StanislavJochman/ROBa-project/bumper.3mf

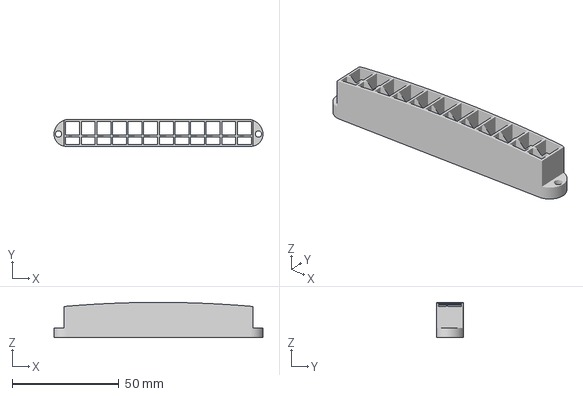
[picture p10: CAD file, 2023-11-16]
bumper.3mf
97.7 x 12.5 x 16.5 mm
