StanislavJochman/ROBa-project/LineFollower.brd

## EAGLE design LineFollower.brd (2023-11-15)

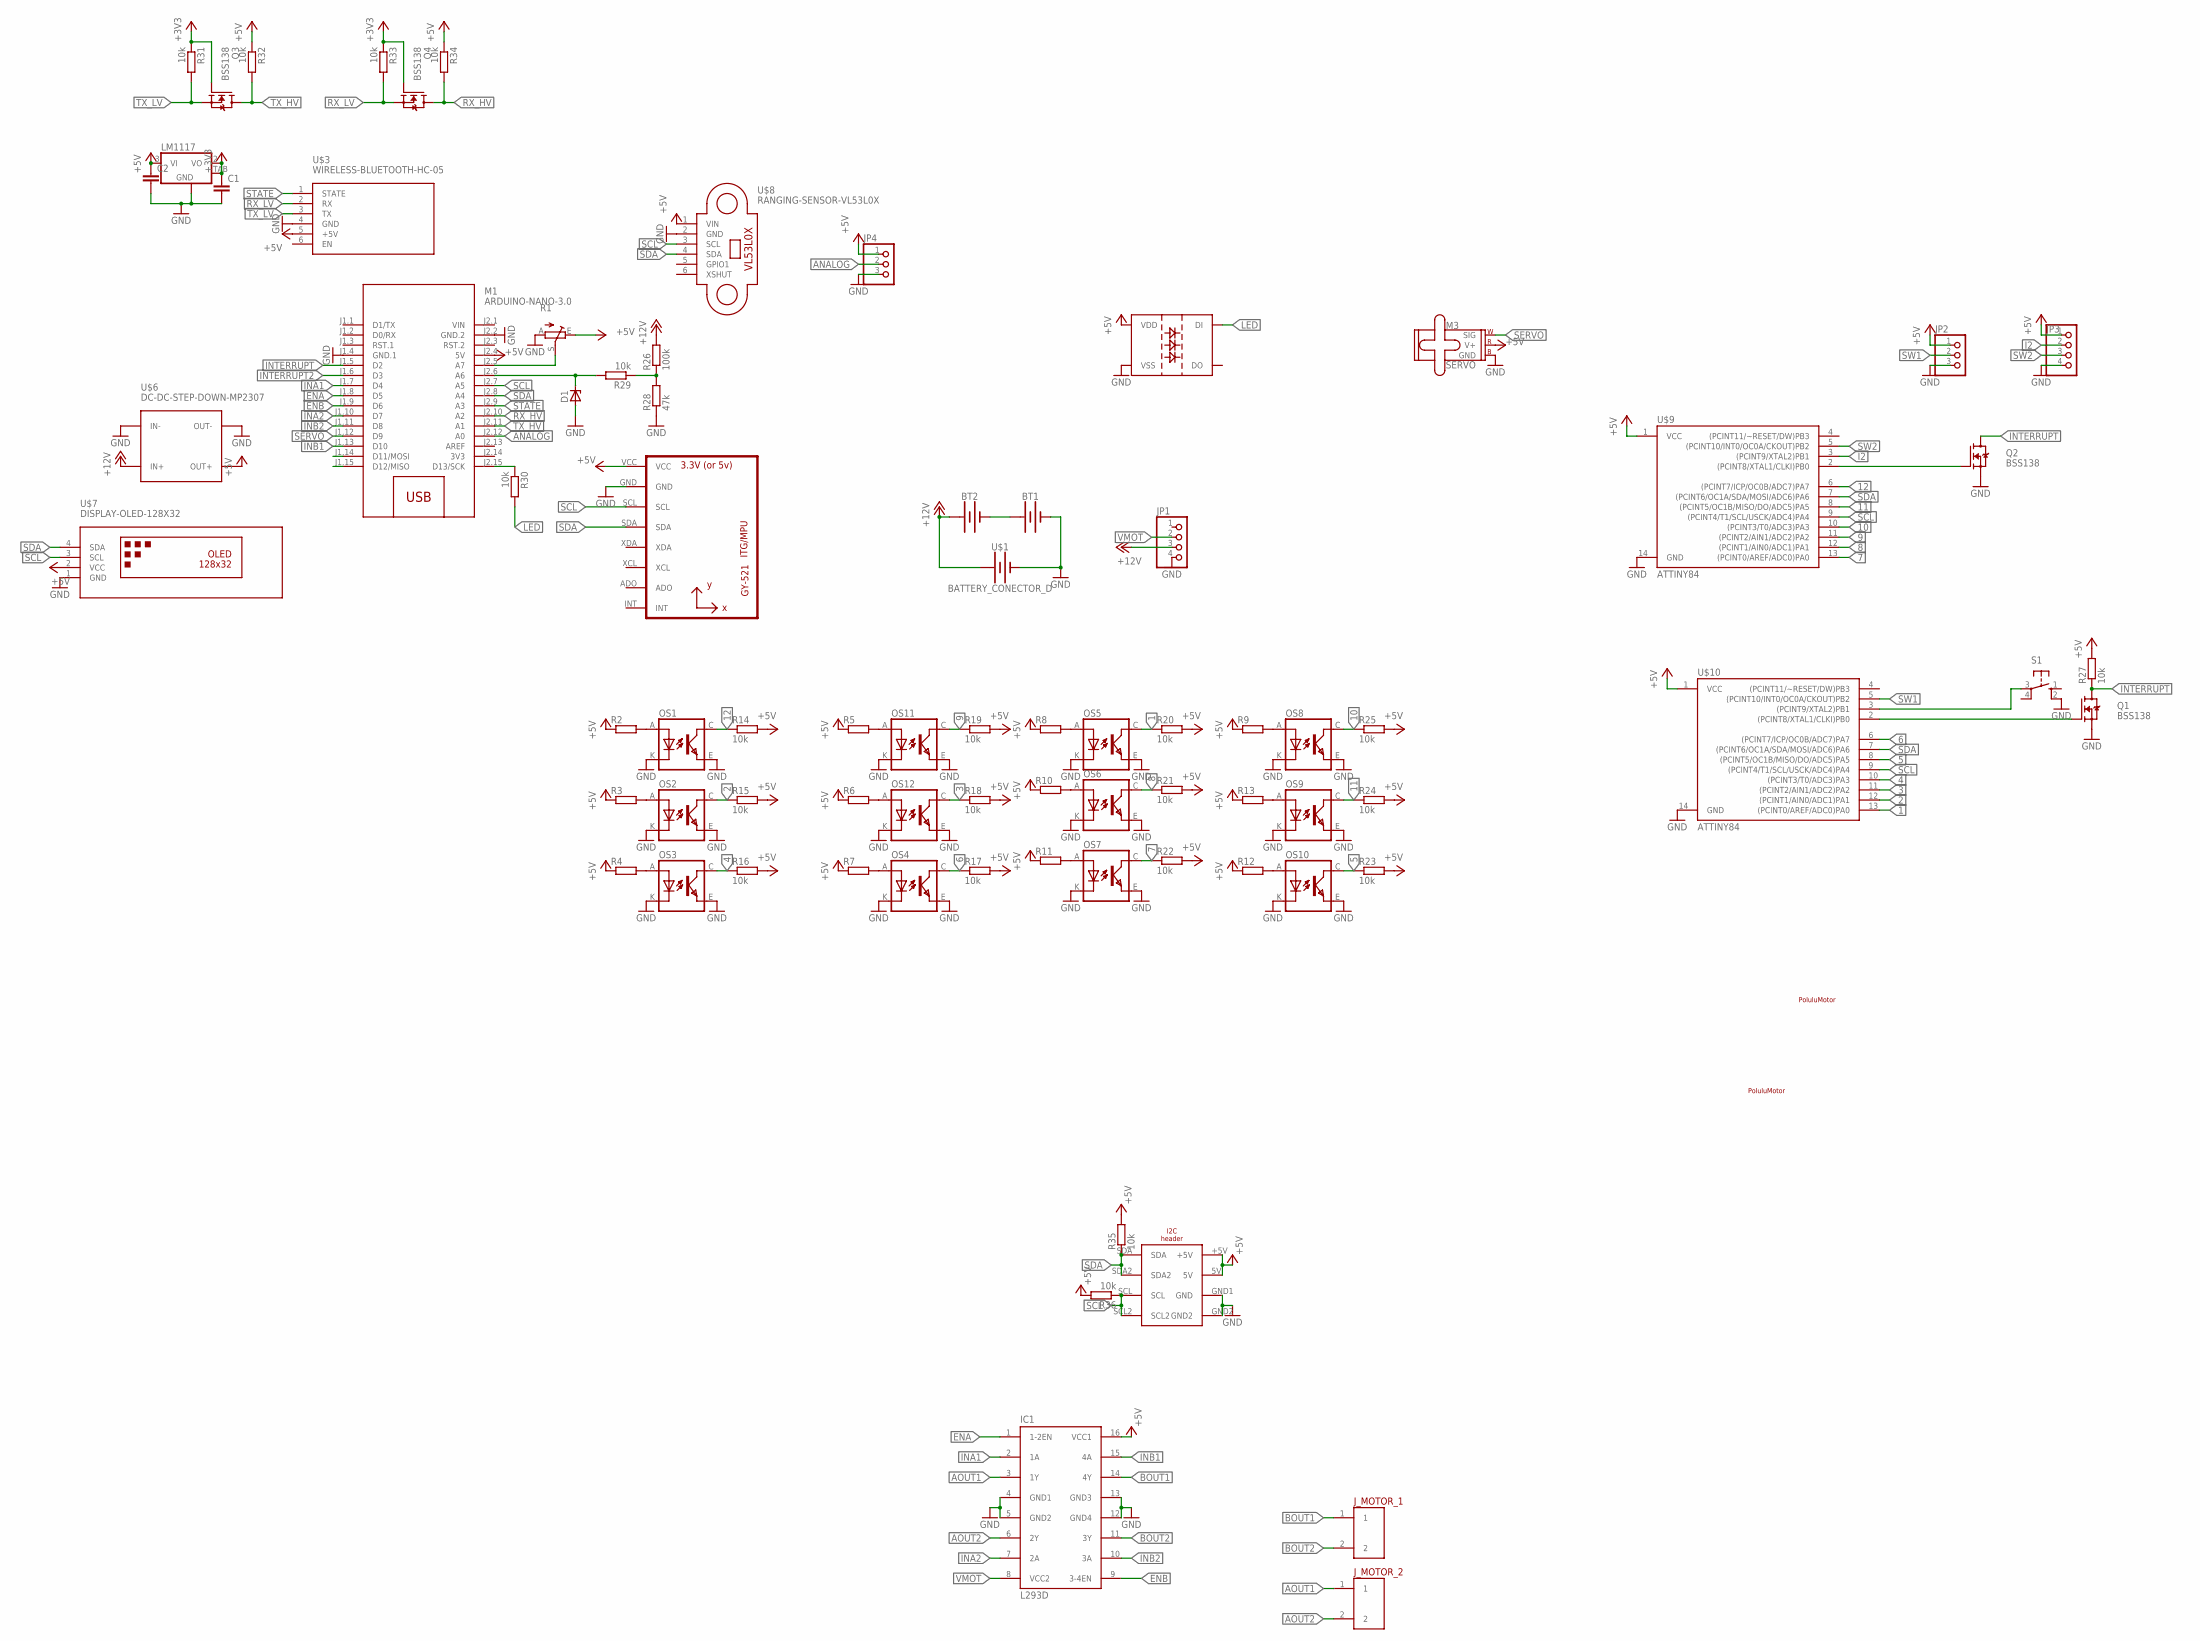
[picture p11: schematic LineFollower.sch]

Parts:
BT1, BT2: BATTERY-AA_KIT; BATTERY-AA-KIT
C1, C2: C-EUC1206; C1206
D1: ZENER-DIODESOD80C; SOD80C
IC1: L293D; L293
JP1, JP3: PINHD-1X4; 1X04
JP2, JP4: PINHD-1X3; 1X03
J_MOTOR_1, J_MOTOR_2: MOTOR_CONNECTOR; MOTOR_CONNECTOR_FOOTPRINT
LED1: WS2812B
M1: ARDUINO-NANO-3.0
M3: SERVO; 1X03
OS1, OS2, OS3, OS4, OS5, OS6, OS7, OS8, OS9, OS10, OS11, OS12: TCRT5000
Q1, Q2, Q3, Q4: BSS138; SOT23
R1: TRIM_EU-RJ9W; RJ9W
R2, R3, R4, R5, R6, R7, R8, R9, R10, R11, R12, R13: R-EU_M1206; M1206
R14, R15, R16, R17, R18, R19, R20, R21, R22, R23, R24, R25, R27, R29, R30, R31, R32, R33, R34, R35, R36: 10k; M1206
R26: 100k; M1206
R28: 47k; M1206
S1: 10-XX; B3F-10XX
U1: MPU-6050MPU6050; MPU-6050
U$1: BATTERY_CONECTOR_D
U$2: I2C_HEADER; I2_HEADER
U$3: WIRELESS-BLUETOOTH-HC-05
U$4: LM1117
U$6: DC-DC-STEP-DOWN-MP2307
U$7: DISPLAY-OLED-128X32
U$8: RANGING-SENSOR-VL53L0X
U$9, U$10: ATTINY84; SO14
U$12, U$13: POLULU_MOTOR

Connections:
1: OS5.C (COLLECTOR), R20.1, U$10.13 ((PCINT0/AREF/ADC0)PA0)
2: OS2.C (COLLECTOR), R15.1, U$10.12 ((PCINT1/AIN0/ADC1)PA1)
3: OS12.C (COLLECTOR), R18.1, U$10.11 ((PCINT2/AIN1/ADC2)PA2)
3V3: M1.J2.14 (3V3)
4: OS3.C (COLLECTOR), R16.1, U$10.10 ((PCINT3/T0/ADC3)PA3)
5: OS10.C (COLLECTOR), R23.1, U$10.8 ((PCINT5/OC1B/MISO/DO/ADC5)PA5)
6: OS4.C (COLLECTOR), R17.1, U$10.6 ((PCINT7/ICP/OC0B/ADC7)PA7)
7: OS7.C (COLLECTOR), R22.1, U$9.13 ((PCINT0/AREF/ADC0)PA0)
8: OS6.C (COLLECTOR), R21.1, U$9.12 ((PCINT1/AIN0/ADC1)PA1)
9: OS11.C (COLLECTOR), R19.1, U$9.11 ((PCINT2/AIN1/ADC2)PA2)
10: OS8.C (COLLECTOR), R25.1, U$9.10 ((PCINT3/T0/ADC3)PA3)
11: OS9.C (COLLECTOR), R24.1, U$9.8 ((PCINT5/OC1B/MISO/DO/ADC5)PA5)
12: OS1.C (COLLECTOR), R14.1, U$9.6 ((PCINT7/ICP/OC0B/ADC7)PA7)
+3V3: C1.1, Q3.1 (G), Q4.1 (G), R31.1, R33.1, U$4.2 (VO), U$4.TAB (OUT)
+5V: C2.1, IC1.16 (VCC1), JP2.1, JP3.1, JP4.1, LED1.1 (VDD), M1.J2.4 (5V), M3.2 (V+), R1.E, R2.1, R3.1, R4.1, R5.1, R6.1, R7.1, R8.1, R9.1, R10.1, R11.1, R12.1, R13.1, R14.2, R15.2, R16.2, R17.2, R18.2, R19.2, R20.2, R21.2, R22.2, R23.2, R24.2, R25.2, R27.2, R32.1, R34.1, R35.2, R36.2, U1.VCC, U$2.5V, U$2.+5V, U$3.5 (+5V), U$4.3 (VI), U$6.OUT+, U$7.2 (VCC), U$8.1 (VIN), U$9.1 (VCC), U$10.1 (VCC)
+12V: BT2.PWR@1 (+), JP1.3, R26.2, U$1.+, U$6.IN+
ANALOG: JP4.2, M1.J2.12 (A0)
AOUT1: IC1.3 (1Y), J_MOTOR_2.1
AOUT2: IC1.6 (2Y), J_MOTOR_2.2
BOUT1: IC1.14 (4Y), J_MOTOR_1.1
BOUT2: IC1.11 (3Y), J_MOTOR_1.2
ENA: IC1.1 (1-2EN), M1.J1.8 (D5)
ENB: IC1.9 (3-4EN), M1.J1.9 (D6)
GND: BT1.GND@1 (-), C1.2, C2.2, D1.A, IC1.4 (GND1), IC1.5 (GND2), IC1.12 (GND4), IC1.13 (GND3), JP1.4, JP2.3, JP3.4, JP4.3, LED1.3 (VSS), M1.J1.4 (GND.1), M1.J2.2 (GND.2), M3.3 (GND), OS1.E (EMITTER), OS1.K (CATHODE), OS2.E (EMITTER), OS2.K (CATHODE), OS3.E (EMITTER), OS3.K (CATHODE), OS4.E (EMITTER), OS4.K (CATHODE), OS5.E (EMITTER), OS5.K (CATHODE), OS6.E (EMITTER), OS6.K (CATHODE), OS7.E (EMITTER), OS7.K (CATHODE), OS8.E (EMITTER), OS8.K (CATHODE), OS9.E (EMITTER), OS9.K (CATHODE), OS10.E (EMITTER), OS10.K (CATHODE), OS11.E (EMITTER), OS11.K (CATHODE), OS12.E (EMITTER), OS12.K (CATHODE), Q1.2 (S), Q2.2 (S), R1.A, R28.1, S1.2 (S1), U1.GND, U$1.-, U$2.GND1 (GND), U$2.GND2, U$3.4 (GND), U$4.1 (GND), U$6.IN-, U$6.OUT-, U$7.1 (GND), U$8.2 (GND), U$9.14 (GND), U$10.14 (GND)
I2: JP3.2, U$9.3 ((PCINT9/XTAL2)PB1)
INA1: IC1.2 (1A), M1.J1.7 (D4)
INA2: IC1.7 (2A), M1.J1.10 (D7)
INB1: IC1.15 (4A), M1.J1.13 (D10)
INB2: IC1.10 (3A), M1.J1.11 (D8)
INTERRUPT: M1.J1.5 (D2), Q1.3 (D), Q2.3 (D), R27.1
INTERRUPT2: M1.J1.6 (D3)
LED: LED1.4 (DI), R30.2
unnamed: M1.J2.5 (A7), R1.S
unnamed: BT1.PWR@1 (+), BT2.GND@1 (-)
unnamed: Q1.1 (G), U$10.2 ((PCINT8/XTAL1/CLKI)PB0)
unnamed: Q2.1 (G), U$9.2 ((PCINT8/XTAL1/CLKI)PB0)
unnamed: S1.3, U$10.3 ((PCINT9/XTAL2)PB1)
unnamed: R26.1, R28.2, R29.1
unnamed: OS1.A (ANODE), R2.2
unnamed: OS2.A (ANODE), R3.2
unnamed: OS3.A (ANODE), R4.2
unnamed: OS11.A (ANODE), R5.2
unnamed: OS12.A (ANODE), R6.2
unnamed: OS4.A (ANODE), R7.2
unnamed: OS5.A (ANODE), R8.2
unnamed: OS6.A (ANODE), R10.2
unnamed: OS7.A (ANODE), R11.2
unnamed: OS10.A (ANODE), R12.2
unnamed: OS9.A (ANODE), R13.2
unnamed: OS8.A (ANODE), R9.2
unnamed: D1.C, M1.J2.6 (A6), R29.2
unnamed: M1.J2.15 (D13/SCK), R30.1
RX_HV: M1.J2.10 (A2), Q4.3 (D), R34.2
RX_LV: Q4.2 (S), R33.2, U$3.2 (RX)
SCL: M1.J2.7 (A5), R36.1, U1.SCL, U$2.SCL, U$2.SCL2, U$7.3 (SCL), U$8.3 (SCL), U$9.9 ((PCINT4/T1/SCL/USCK/ADC4)PA4), U$10.9 ((PCINT4/T1/SCL/USCK/ADC4)PA4)
SDA: M1.J2.8 (A4), R35.1, U1.SDA, U$2.SDA, U$2.SDA2, U$7.4 (SDA), U$8.4 (SDA), U$9.7 ((PCINT6/OC1A/SDA/MOSI/ADC6)PA6), U$10.7 ((PCINT6/OC1A/SDA/MOSI/ADC6)PA6)
SERVO: M1.J1.12 (D9), M3.1 (SIG)
STATE: M1.J2.9 (A3), U$3.1 (STATE)
SW1: JP2.2, U$10.5 ((PCINT10/INT0/OC0A/CKOUT)PB2)
SW2: JP3.3, U$9.5 ((PCINT10/INT0/OC0A/CKOUT)PB2)
TX_HV: M1.J2.11 (A1), Q3.3 (D), R32.2
TX_LV: Q3.2 (S), R31.2, U$3.3 (TX)
VIN: M1.J2.1 (VIN)
VMOT: IC1.8 (VCC2), JP1.2

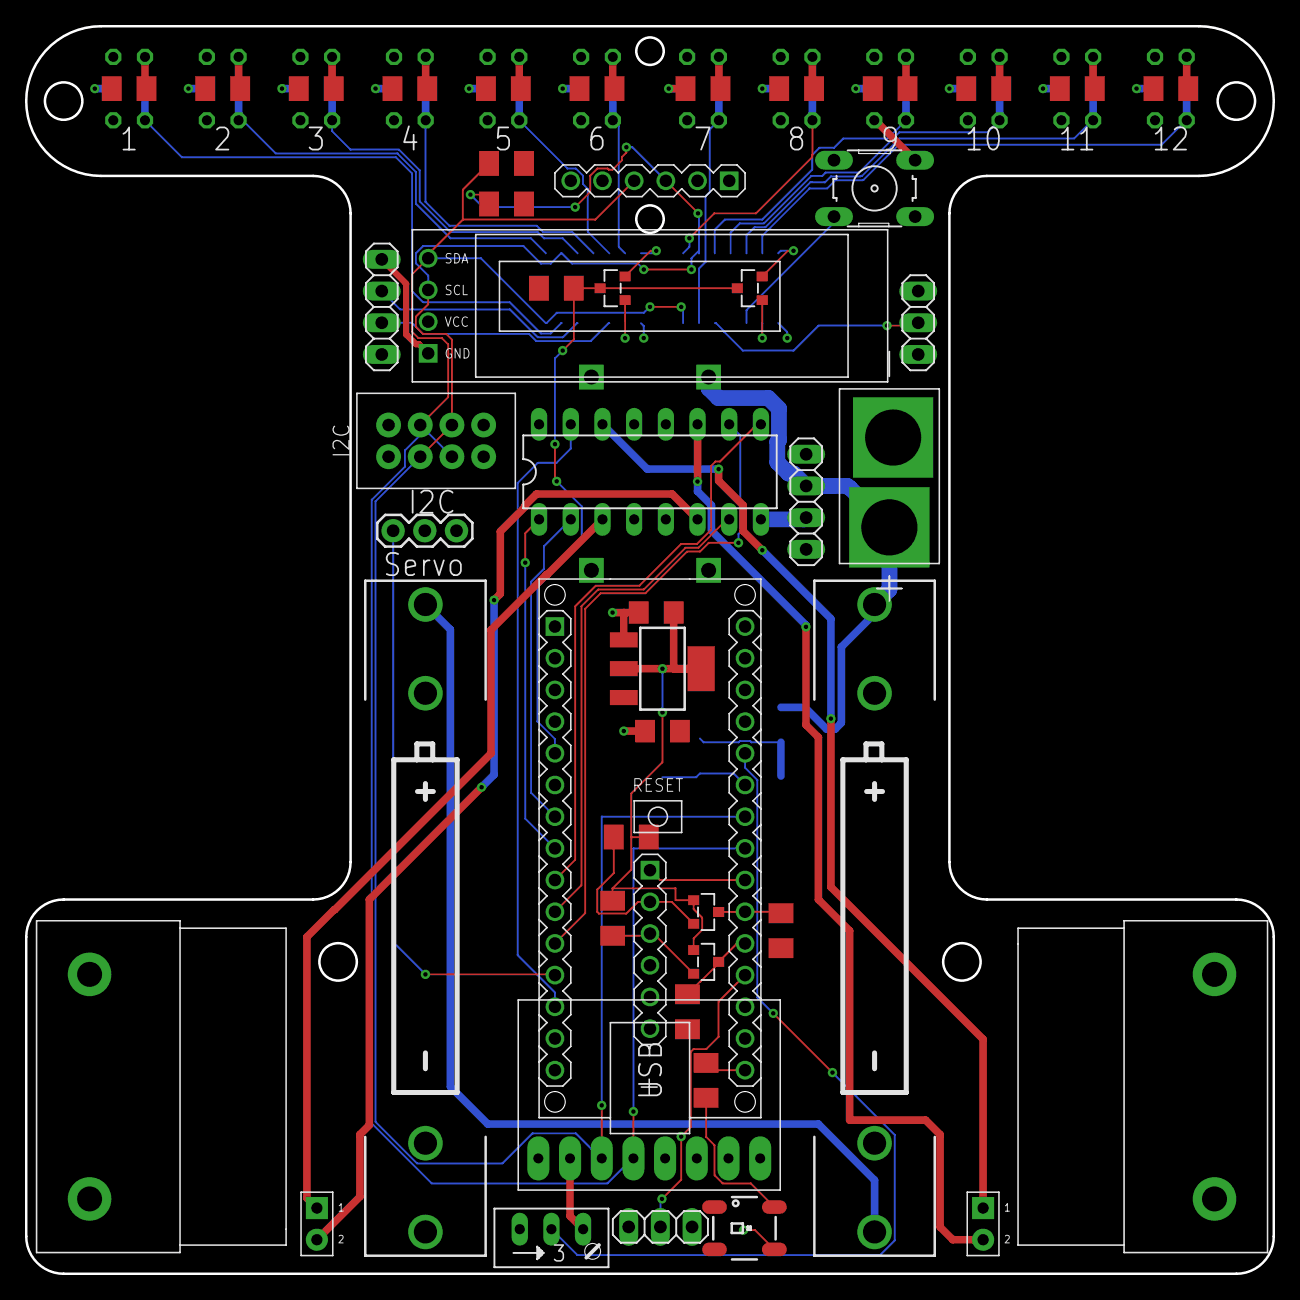
[picture p12: board LineFollower.brd from above]

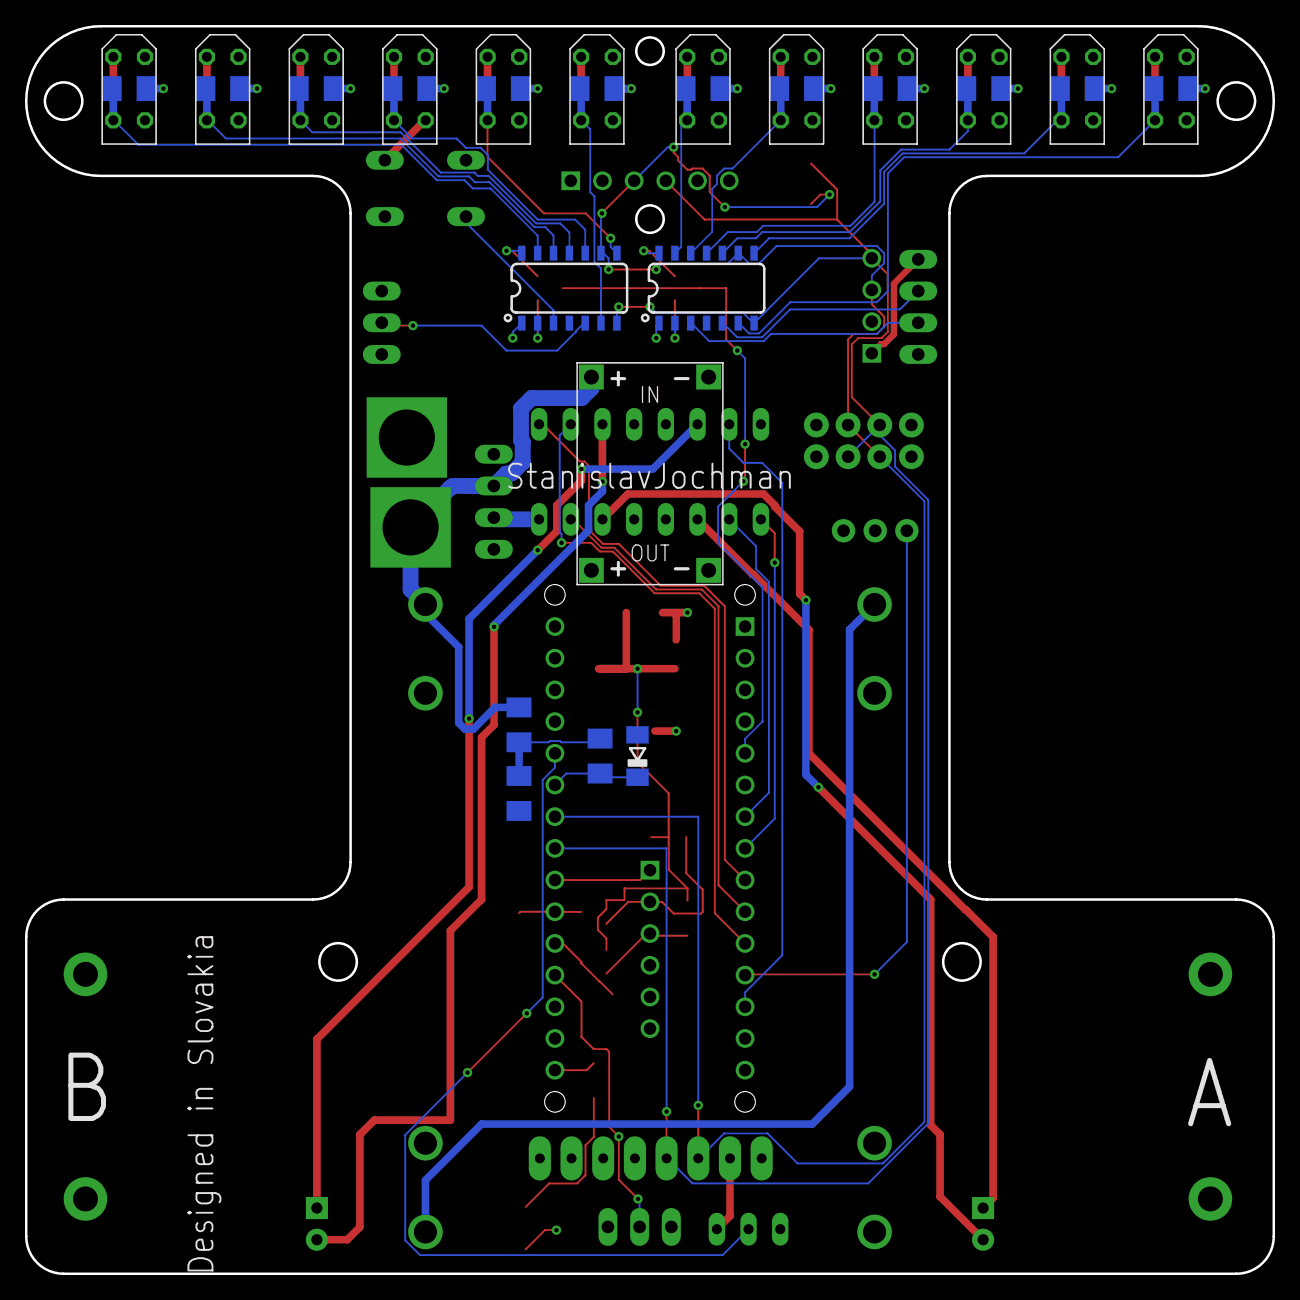
[picture p13: board LineFollower.brd from below]

Board: 2 copper layers, 100.0 x 100.0 mm, 80 parts (19 on the bottom side), 61 nets.
