StanislavJochman/ROBa-project/Bot/define_nano.h

/////////////////////////////////////////////////////////
#define button 4
/////////////////////////////////////////////////////////
/////////////////////////////////////////////////////////
#define ENB 6
#define ENA 5
#define INB2 8
#define INB1 10 
#define INA2 7
#define INA1 4
#define servo_pin 9
#define pot A7
