StanislavJochman/ROBa-project/Bot/define.h

/////////////////////////////////////////////////////////
#define L1 A3
#define L2 A2
#define L3 A1
#define L4 A8
#define L5 A7
#define L6 A6
#define ENAL 5
/////////////////////////////////////////////////////////
#define ENCA 1
#define ENCB 0
/////////////////////////////////////////////////////////
#define button 7
/////////////////////////////////////////////////////////
/////////////////////////////////////////////////////////
#define ENB 9
#define ENA 10
#define INB2 A0
#define INB1 15 
#define INA2 16
#define INA1 14

#define sensor_window_size 3
